Pedro-ub/tdse-tf_2026-1erC_3-02/README.md

# FIUBA - Electrónica - Taller de Sistemas Embebidos
## Trabajo Final - Año-Cuatrimestre - Curso-Grupo: Título del Trabajo Final
### Bitácora de Entregas
| N° | Detalles | Fecha | Deadline |
| :--: | :--- | :---: | :---: |
| 01 | README.md | 19/05/26 | Semana 08 |
| 02 | Propuesta.md | | Semana 11 |
| 03 | Informe_de_Avance.md | | Semana 14 |
| 04 | Memoria_Video_Código.md | | Semana 17 |
