Pedro-ub/tdse-tf_2026-1erC_3-02/Inc/main.h

#define B1_Pin GPIO_PIN_13
#define B1_GPIO_Port GPIOC
#define B1_EXTI_IRQn EXTI15_10_IRQn
#define USART_TX_Pin GPIO_PIN_2
#define USART_TX_GPIO_Port GPIOA
#define USART_RX_Pin GPIO_PIN_3
#define USART_RX_GPIO_Port GPIOA
#define SENSOR_1_Pin GPIO_PIN_5
#define SENSOR_1_GPIO_Port GPIOC
#define BTN_D_Pin GPIO_PIN_7
#define BTN_D_GPIO_Port GPIOC
#define BTN_C_Pin GPIO_PIN_8
#define BTN_C_GPIO_Port GPIOC
#define BTN_B_Pin GPIO_PIN_9
#define BTN_B_GPIO_Port GPIOC
#define BTN_A_Pin GPIO_PIN_8
#define BTN_A_GPIO_Port GPIOA
#define TMS_Pin GPIO_PIN_13
#define TMS_GPIO_Port GPIOA
#define TCK_Pin GPIO_PIN_14
#define TCK_GPIO_Port GPIOA
#define DIP_1_Pin GPIO_PIN_10
#define DIP_1_GPIO_Port GPIOC
#define DIP_0_Pin GPIO_PIN_12
#define DIP_0_GPIO_Port GPIOC
#define SWO_Pin GPIO_PIN_3
#define SWO_GPIO_Port GPIOB
#define DIP_3_Pin GPIO_PIN_4
#define DIP_3_GPIO_Port GPIOB
#define DIP_2_Pin GPIO_PIN_5
#define DIP_2_GPIO_Port GPIOB
