Pedro-ub/tdse-tf_2026-1erC_3-02/(commit log)

2026-05-19 Update README.md
    agregue la fecha del README.md a la tabla
2026-05-23 Update PROPUESTA.md
    archivo de propuesta de proyecto final
2026-07-18 esqueleto
    Esqueleto inicial de la memoria técnica para el proyecto 'Whack-A-Mole'
2026-08-09 agregado de imagenes y conclusion
2026-08-10 finalizacion de memoria_video_codigo.md
2026-08-11 resolucion de correcciones
2026-08-11 correccion de fecha incorrecta en tabla
2026-08-12 correccion de puntacion, logo incorrecto y tamaño de imagenes
    Updated image filename and added new sections to the document.
