Pedro-ub/tdse-tf_2026-1erC_3-02/tp_embebidos/atras.jpeg

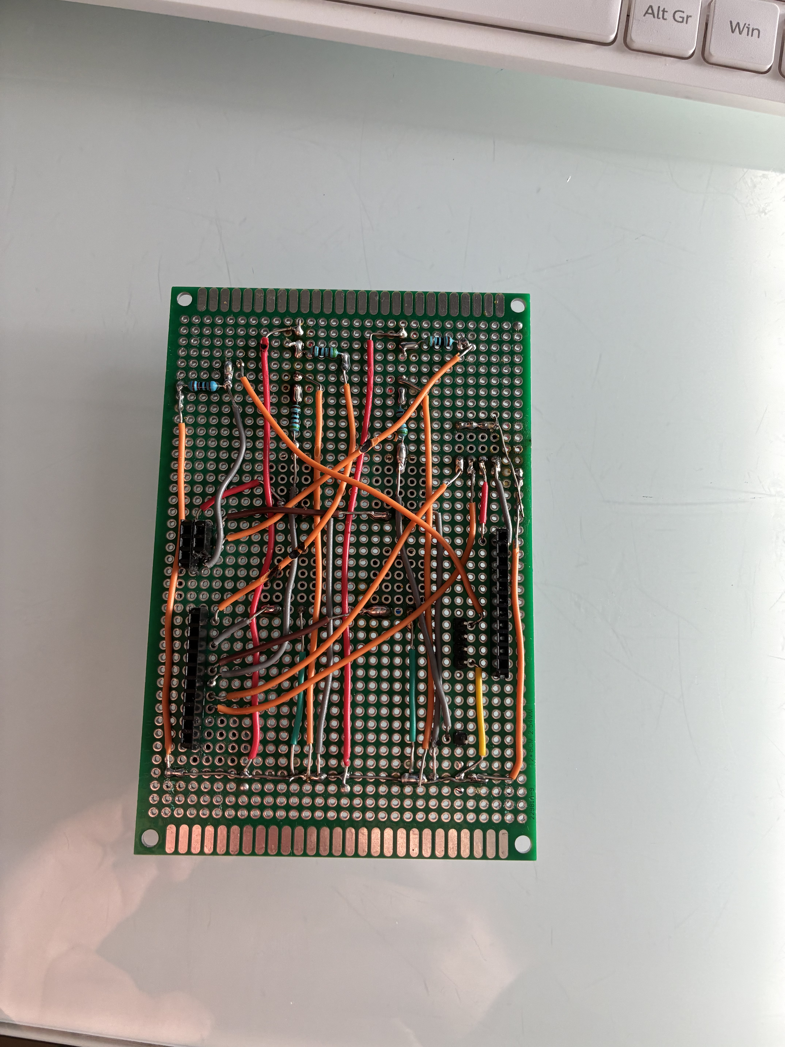
[picture p6: tp_embebidos/atras.jpeg]
tp_embebidos/atras.jpeg
