Pedro-ub/tdse-tf_2026-1erC_3-02/tp_embebidos/shield.jpeg

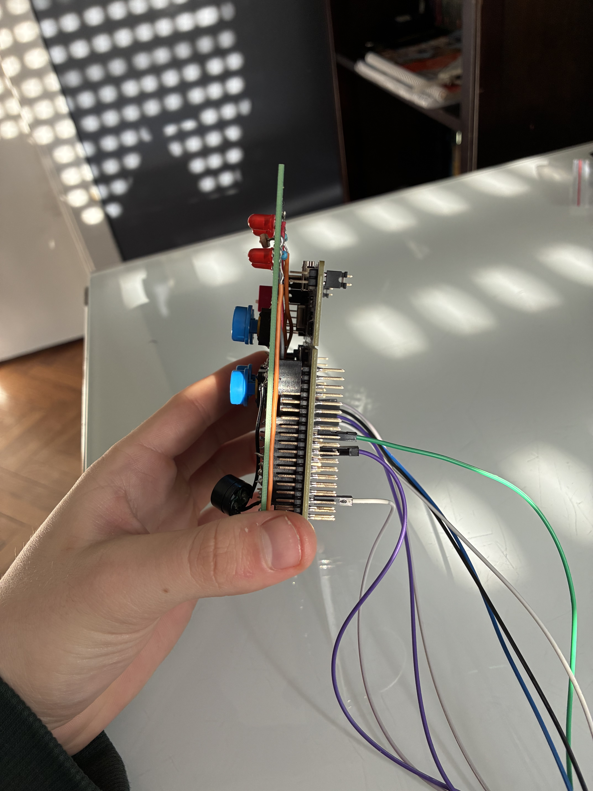
[picture p7: tp_embebidos/shield.jpeg]
tp_embebidos/shield.jpeg
