Pedro-ub/tdse-tf_2026-1erC_3-02/tp_embebidos/completo.jpeg

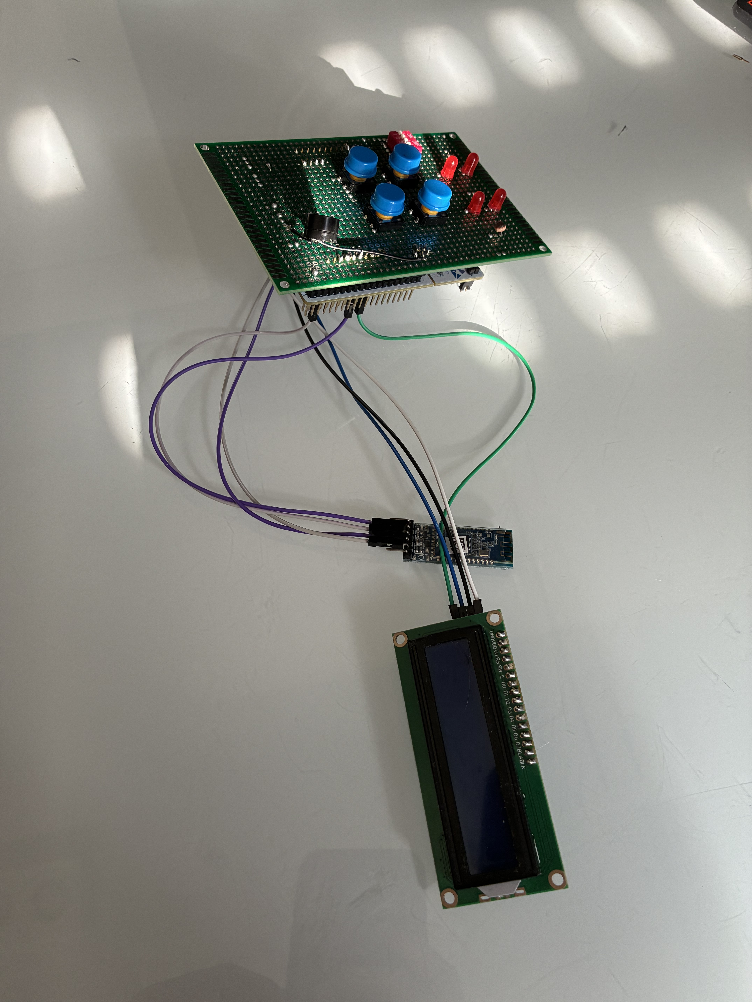
[picture p8: tp_embebidos/completo.jpeg]
tp_embebidos/completo.jpeg
